mhorimoto/M400-k2005111/README.md

# 音声切り替え装置 (A26)
# K2005111

# 要求するHardware

- Arduino Nano V3
- 8ch Relay module
- I2C LCD 1602A (Address:0x27)
