mhorimoto/M400-k2005111/case/VR_RING.FCStd

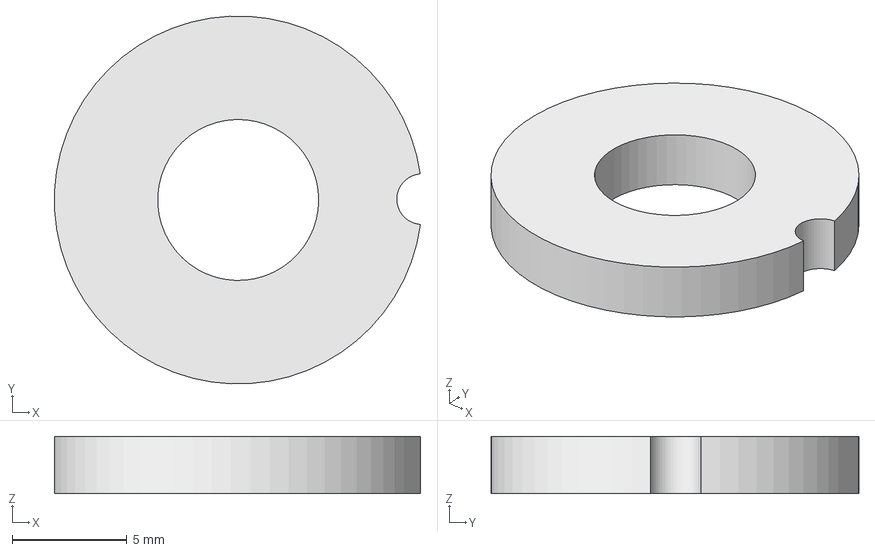
[picture p1: CAD file, 2020-08-31]
case/VR_RING.FCStd
15.9 x 16.0 x 2.50 mm
