mhorimoto/M400-k2005111/(list of files, cad)

Other CAD files:
case/VR_RING.stl
