mhorimoto/M400-k2005111/case/19インチラック部品取り付け図.pdf

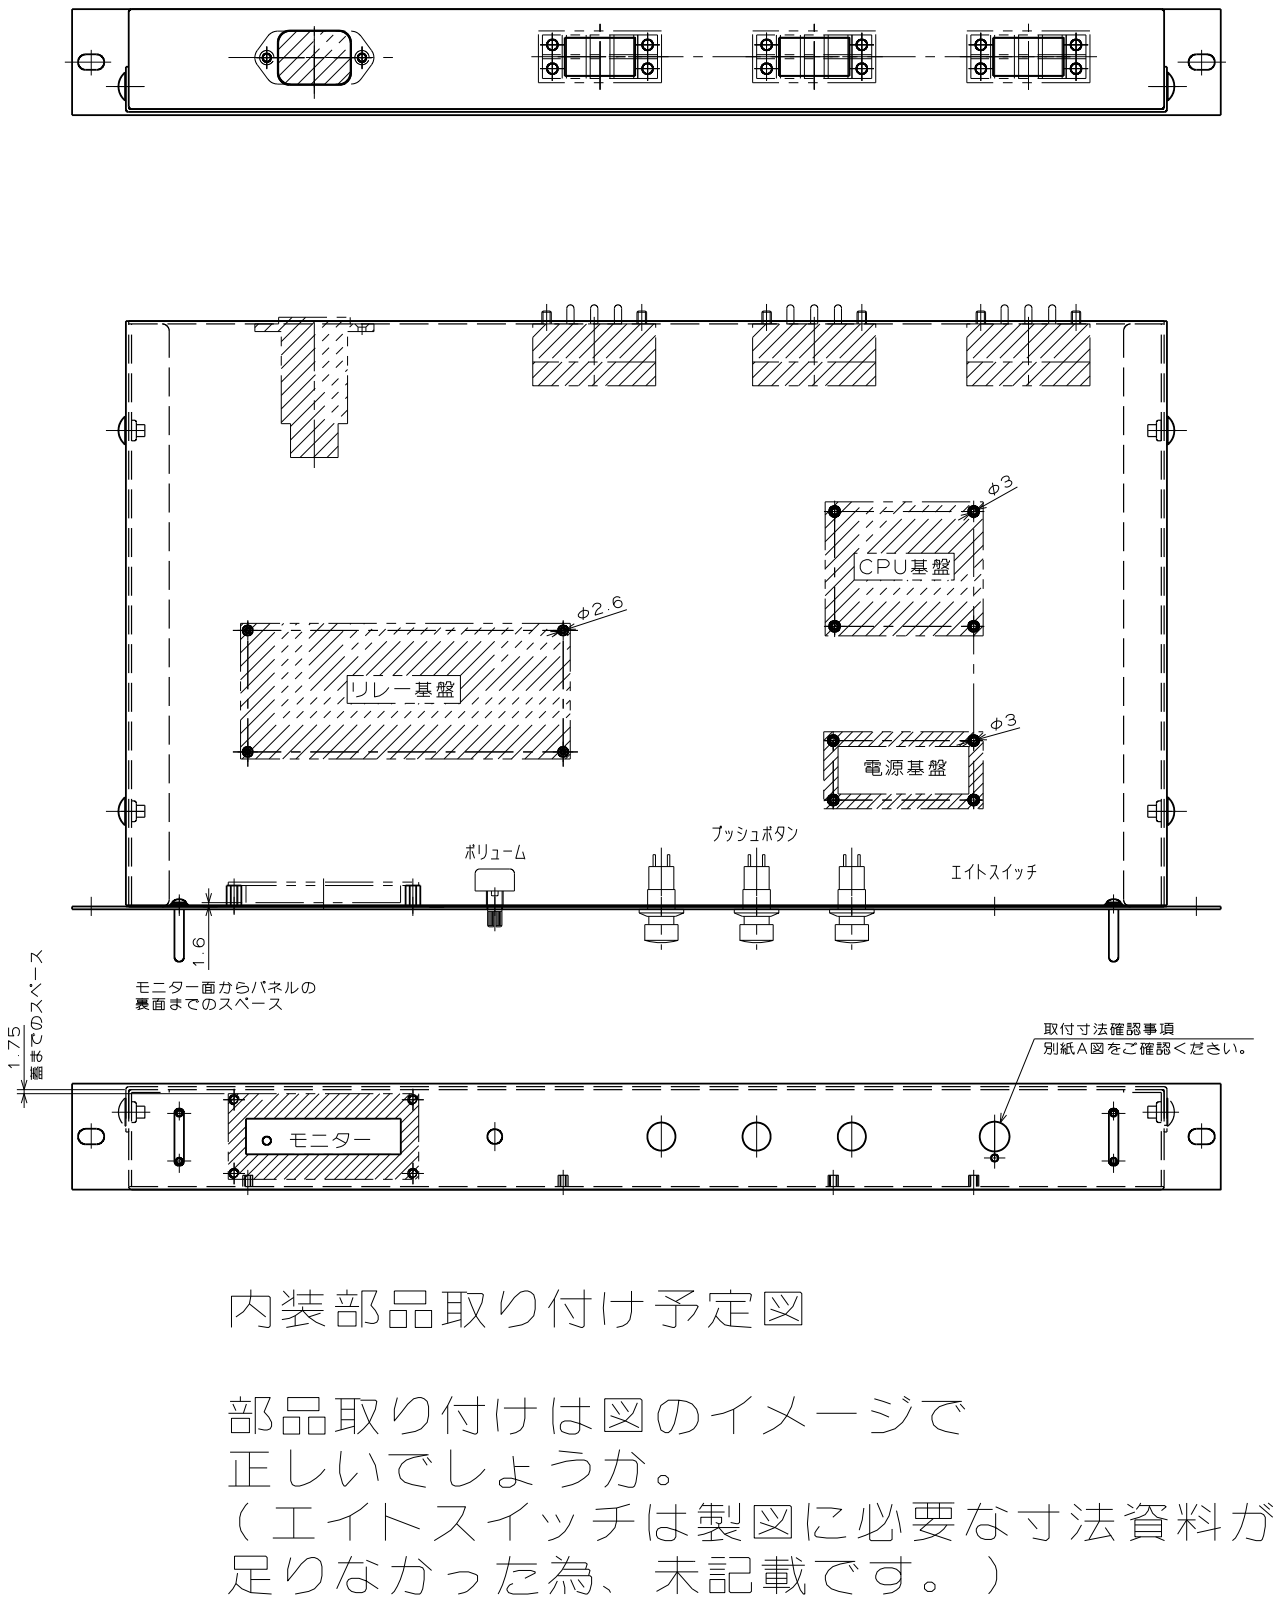
[picture p2: page 1]
