mhorimoto/M400-k2005111/case/19インチラック参考図.pdf

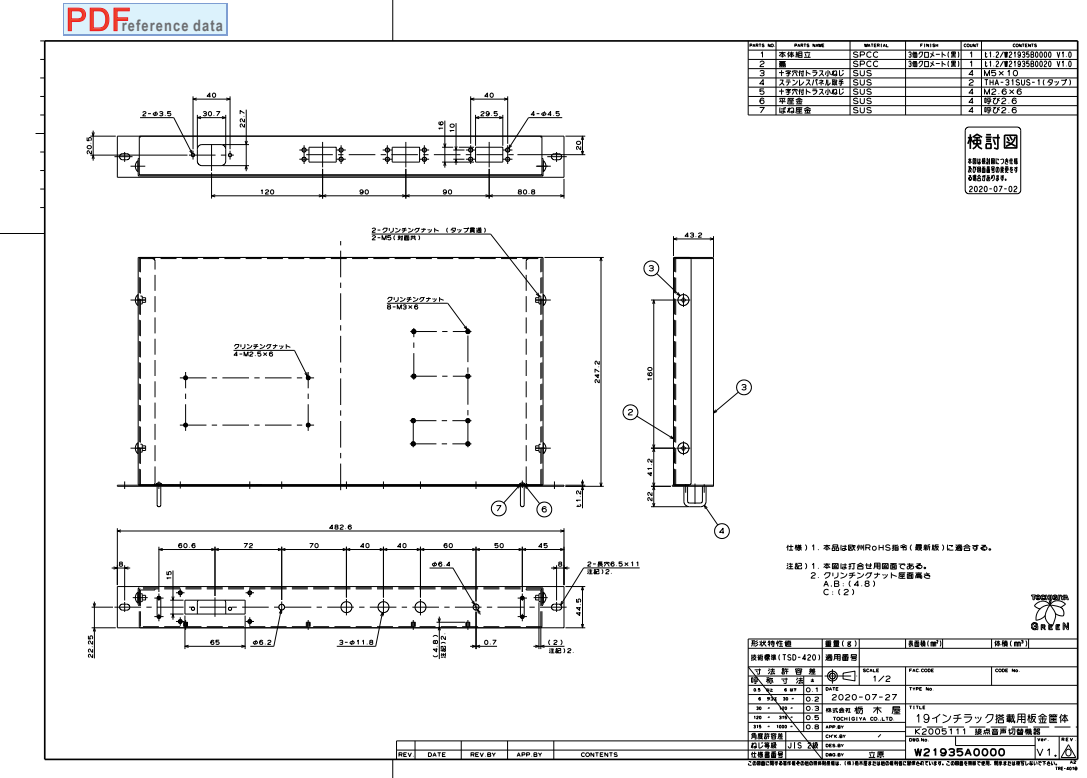
[picture p3: page 1]
PDFreference data

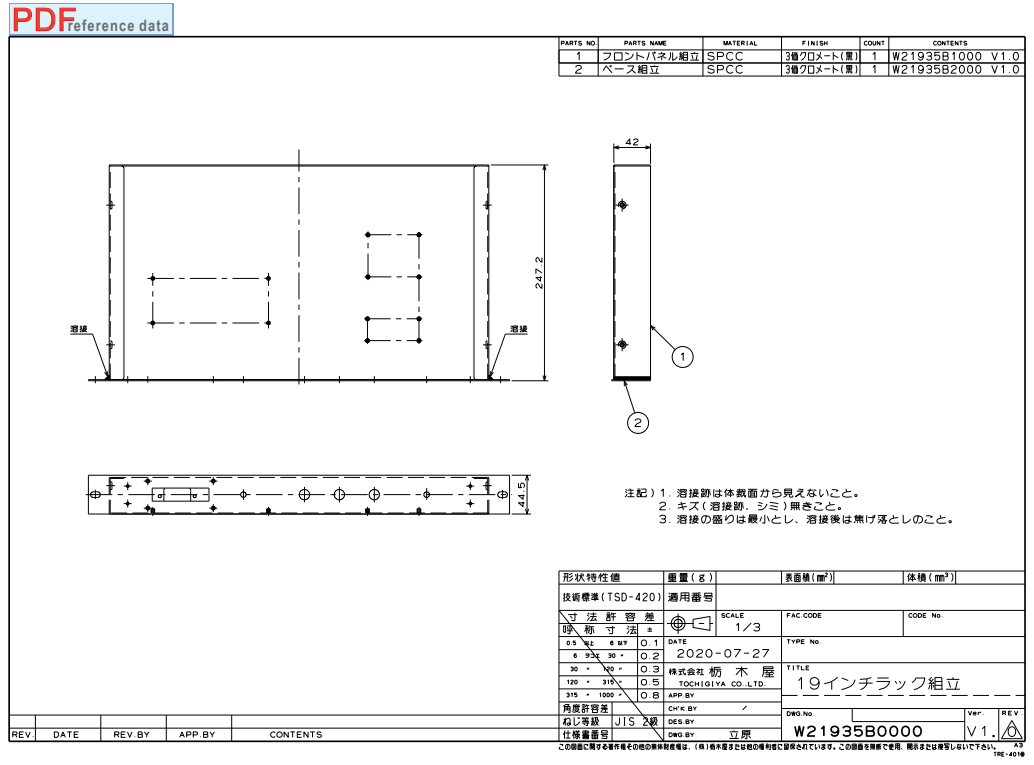
[picture p4: page 2]

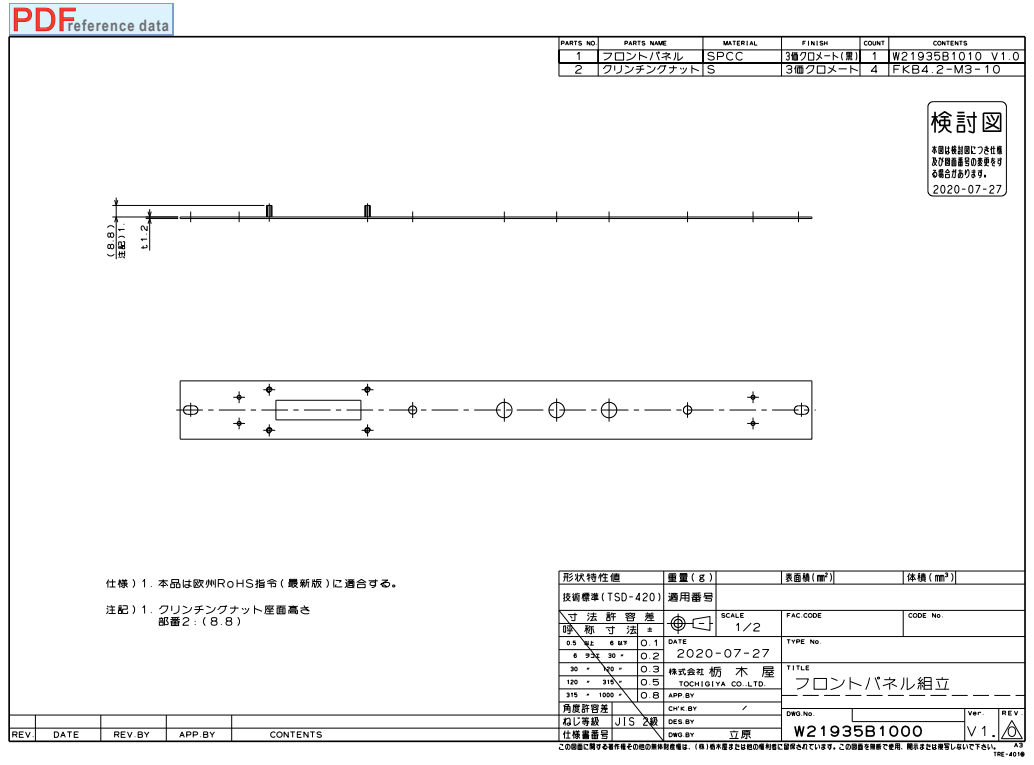
[picture p5: page 3]

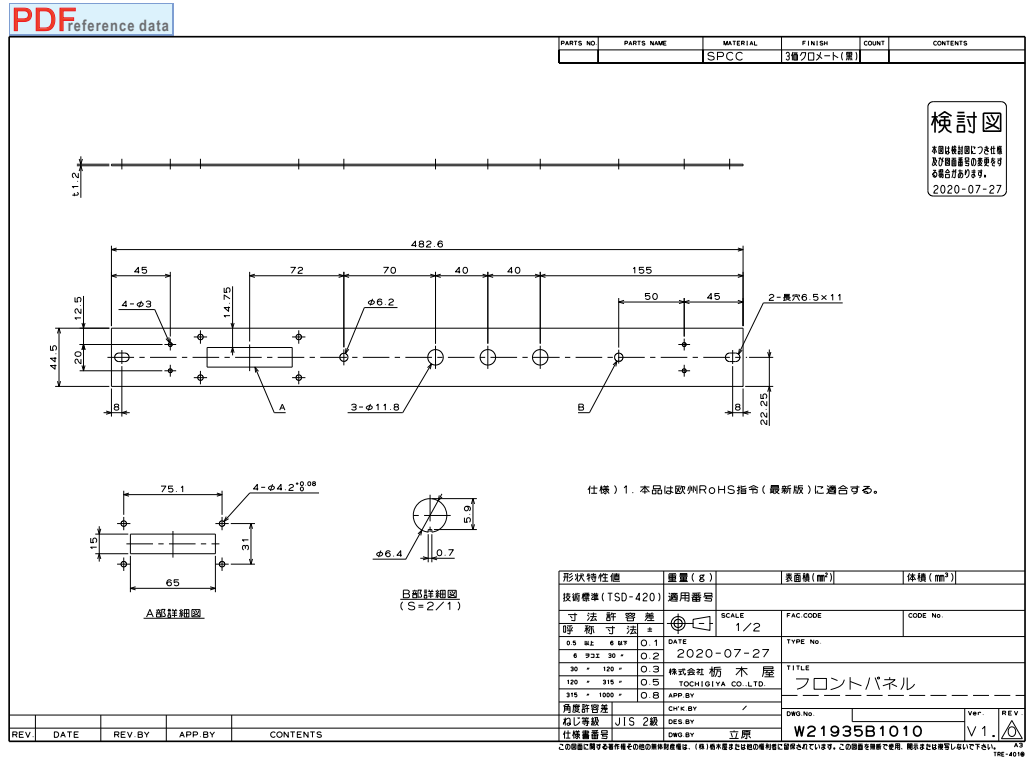
[picture p6: page 4]

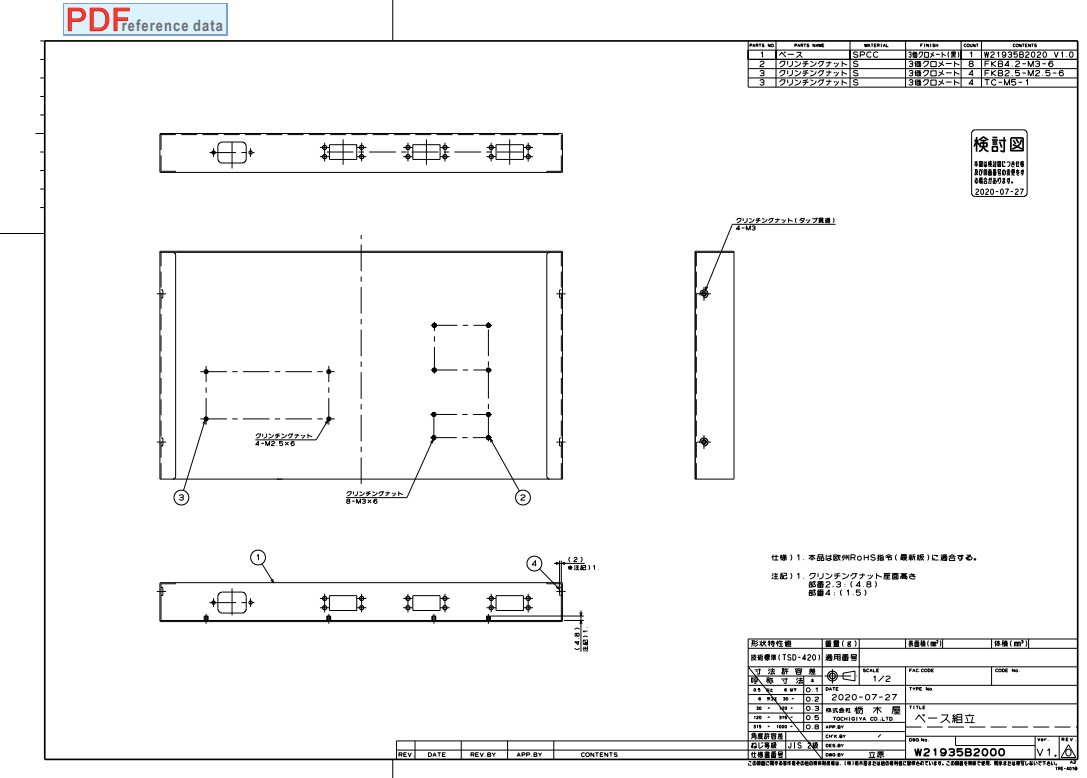
[picture p7: page 5]

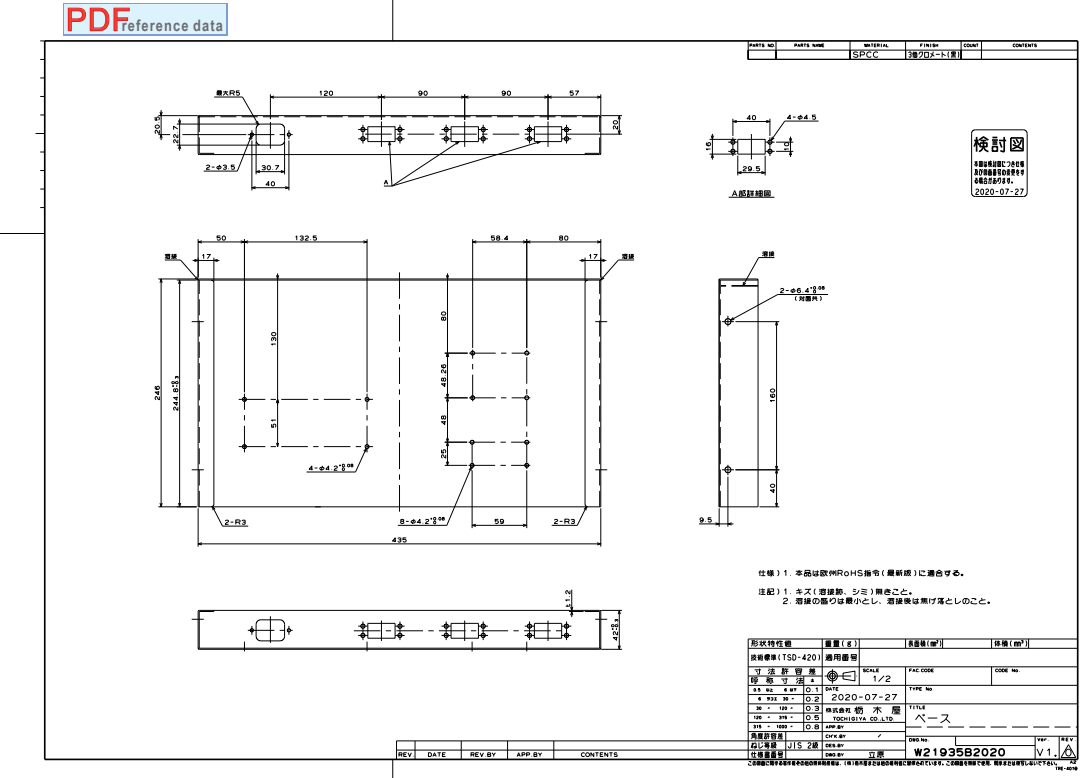
[picture p8: page 6]

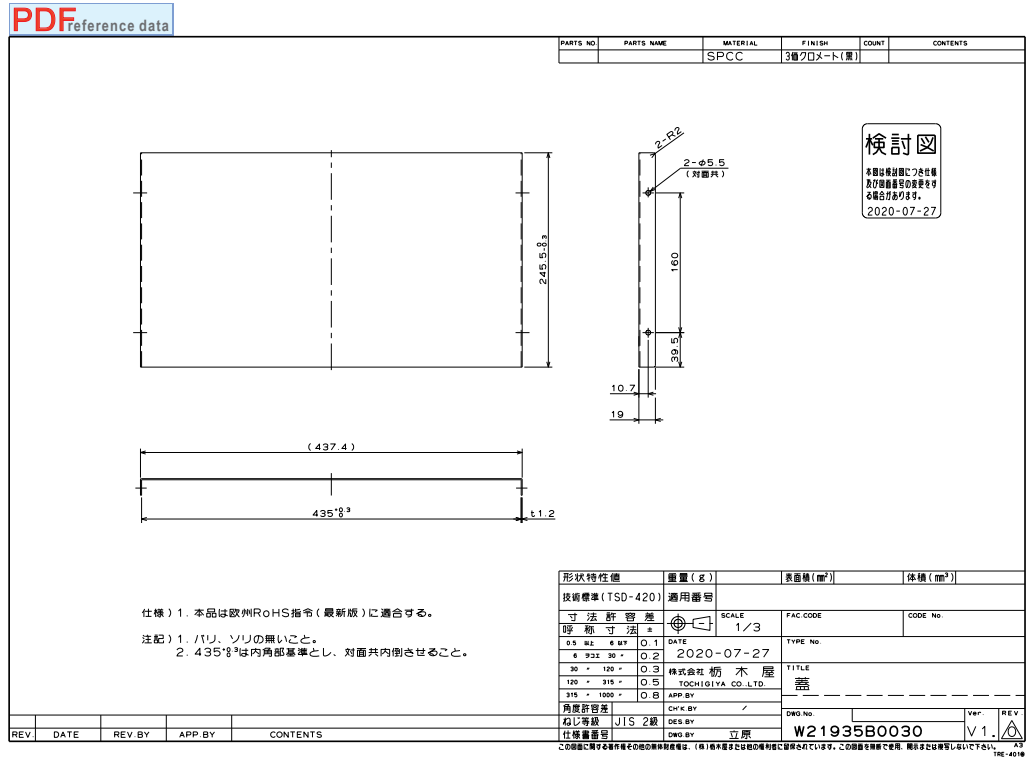
[picture p9: page 7]
