mhorimoto/M400-k2005111/001.kicad_pcb

## KiCad design 001.kicad_pcb (2020-08-08)

Schematic: 001.sch, K2005111

Parts:
C1: 10uF; CP_Radial_D5.0mm_P2.00mm
C2: 0.1uF; C_Disc_D5.0mm_W2.5mm_P2.50mm
CN1: PWR5V; B02B-XH
CN2: JD-VCC; B02B-XH
CN3: TO-RLY; B10B-XH
CN4: I2C-LCD; B04B-XH
CN5: INPUT-A; B02B-XH
CN6: INPUT-B; B02B-XH
CN7: INPUT-C; B02B-XH
CN8: BTN-A; B02B-XH
CN9: BTN-B; B02B-XH
CN10: BTN-C; B02B-XH
CN11: BTN-STOP; B02B-XH
CN12: DELAY-VR; B03B-XH
D1, D2, D3, D4, D5: 1N4007; D_DO-41_SOD81_P10.16mm_Horizontal
M1: ARDUINO-NANO-3.0
R1, R2, R3: 4.7k; R_Axial_DIN0207_L6.3mm_D2.5mm_P10.16mm_Horizontal
RV1, RV2, RV3, RV4, RV5, RV6: TNR10V471K; RV_Disc_D12mm_W3.9mm_P7.5mm
U1, U2, U3: TOSHIBA_TLP222A; TOSHIBA_TLP222A_F_0

Connections:
3V3: M1.J2.14 (3V3)
/5V_JDV: CN2.P$1, D2.1 (K)
/5V_M: C1.1, C2.1, CN1.P$1, D1.2 (A), D2.2 (A)
/5V_MPU: CN3.P$10, CN4.P$3, CN12.P$1, D1.1 (K), D3.2 (A), D4.2 (A), D5.2 (A), M1.J2.4 (5V)
GND: C1.2, C2.2, CN1.P$2, CN2.P$2, CN4.P$4, CN8.P$2, CN9.P$2, CN10.P$2, CN11.P$2, CN12.P$3, M1.J1.4 (GND.1), M1.J2.2 (GND.2), RV2.2, RV4.2, RV6.2, U1.2 (CATHODE), U1.3 (1_DRAIN), U2.2 (CATHODE), U2.3 (1_DRAIN), U3.2 (CATHODE), U3.3 (1_DRAIN)
unnamed: CN3.P$2, CN3.P$3, M1.J1.8 (D5)
unnamed: CN3.P$4, CN3.P$5, M1.J1.7 (D4)
unnamed: CN3.P$6, CN3.P$7, M1.J1.6 (D3)
unnamed: CN3.P$8, CN3.P$9, M1.J1.5 (D2)
unnamed: CN4.P$1, M1.J2.7 (A5)
unnamed: CN4.P$2, M1.J2.8 (A4)
unnamed: CN5.P$1, R1.1, RV1.2, RV2.1
unnamed: CN5.P$2, D3.1 (K), RV1.1
unnamed: CN6.P$1, R2.1, RV3.2, RV4.1
unnamed: CN6.P$2, D4.1 (K), RV3.1
unnamed: CN7.P$1, R3.1, RV5.2, RV6.1
unnamed: CN7.P$2, D5.1 (K), RV5.1
unnamed: CN8.P$1, M1.J1.15 (D12/MISO)
unnamed: CN9.P$1, M1.J1.14 (D11/MOSI)
unnamed: CN10.P$1, M1.J2.15 (D13/SCK)
unnamed: CN11.P$1, M1.J1.13 (D10)
unnamed: CN12.P$2, M1.J2.12 (A0)
unnamed: M1.J1.1 (D1/TX), U1.4 (2_DRAIN)
unnamed: M1.J1.2 (D0/RX), U2.4 (2_DRAIN)
unnamed: M1.J1.12 (D9), U3.4 (2_DRAIN)
unnamed: R1.2, U1.1 (ANODE)
unnamed: R2.2, U2.1 (ANODE)
unnamed: R3.2, U3.1 (ANODE)
VIN: M1.J2.1 (VIN)

Notes on the sheet:
MODEL-400 K2005111

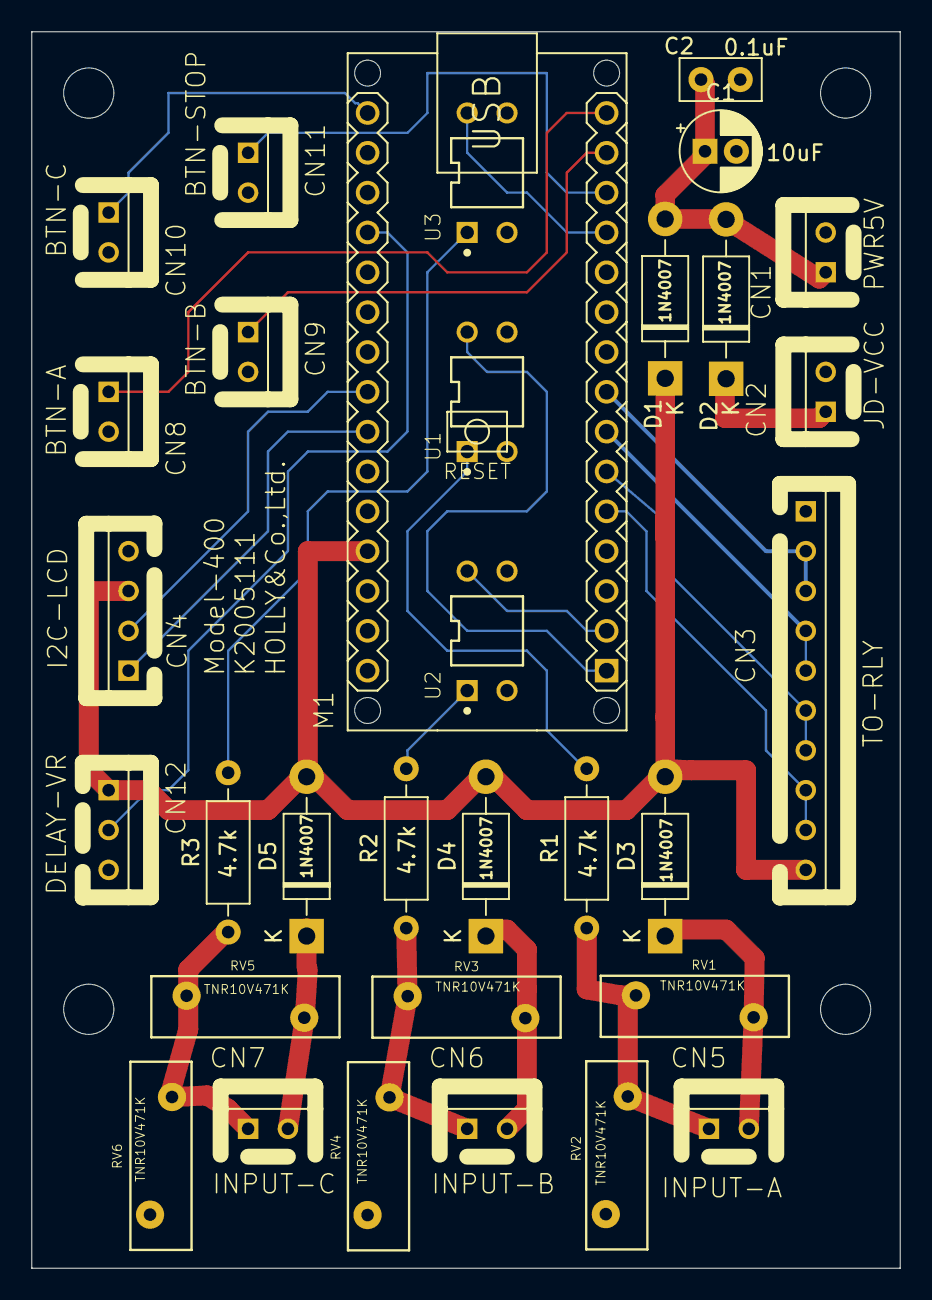
[picture p10: board 001.kicad_pcb from above]

Board: 2 copper layers, 55.4 x 78.8 mm, 32 parts (0 on the bottom side), 27 nets.
