mhorimoto/M400-k2005111/(commit log)

2020-06-15 1N4007に変更
    [001.brd, 001.sch]
2020-06-19 ソースコードと一緒に管理
    [001.brd, 001.sch]
2020-06-19 A11 Remote Mode中にSTOPボタンが効くようにする予定
2020-06-21 CAM初版
    [001.brd, 001.sch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]
2020-06-22 ヴァリスタ追加
    [001.brd, 001.sch]
2020-06-25 KiCADへ移行
    [001.brd, 001.kicad_pcb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]
2020-06-26 foot printを見直し中
    [001.kicad_pcb, 001.sch]
2020-06-27 ガーバーデータも出来た
    [001-B_Mask.gbr, 001-B_SilkS.gbr, 001-Bottom.gbr, 001-Edge_Cuts.gbr, 001-F_Mask.gbr, 001-F_SilkS.gbr, 001-NPTH.drl, 001-PTH.drl]
2020-06-30 GBR初版
2020-07-19 fp-info-cacheが更新されてた
2020-07-19 Arduino IDEに合わせでプログラムを移動
2020-07-21 REMOTE MODEのinstsをswitch()する部分から
2020-07-22 program.ino途中
2020-07-22 A26版でほぼ完成。未検証
2020-07-24 PCBGOGOへ入稿
2020-07-27 GBR出し直し
    [001-B_Mask.gbr, 001-B_SilkS.gbr, 001-Bottom.gbr, 001-Edge_Cuts.gbr, 001-F_Mask.gbr, 001-F_SilkS.gbr, 001-NPTH.drl, 001-PTH.drl]
2020-07-27 RS-274XでX2オプション外してドリル穴は１ファイル化
    [001-B_Mask.gbr, 001-B_SilkS.gbr, 001-Bottom.gbr, 001-Edge_Cuts.gbr, 001-F_Mask.gbr, 001-F_SilkS.gbr, 001-NPTH.drl, 001-Top.gbr]
2020-08-08 フレームを追加とケースの加工データ
    [001.kicad_pcb]
2020-08-31 VR取付支持台を作成
    [VR_RING.FCStd, VR_RING.stl]
2020-09-01 A27 リリースかな。
2020-09-02 KiCAD用ignore file追加
